Nao974/M-BOXE/M-BOXE.jpg

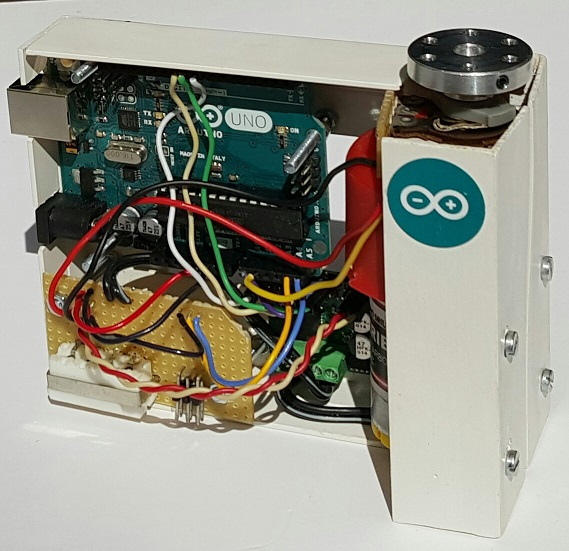
M-BOXE.jpg
