Nao974/M-BOXE/doc/Wiring.png

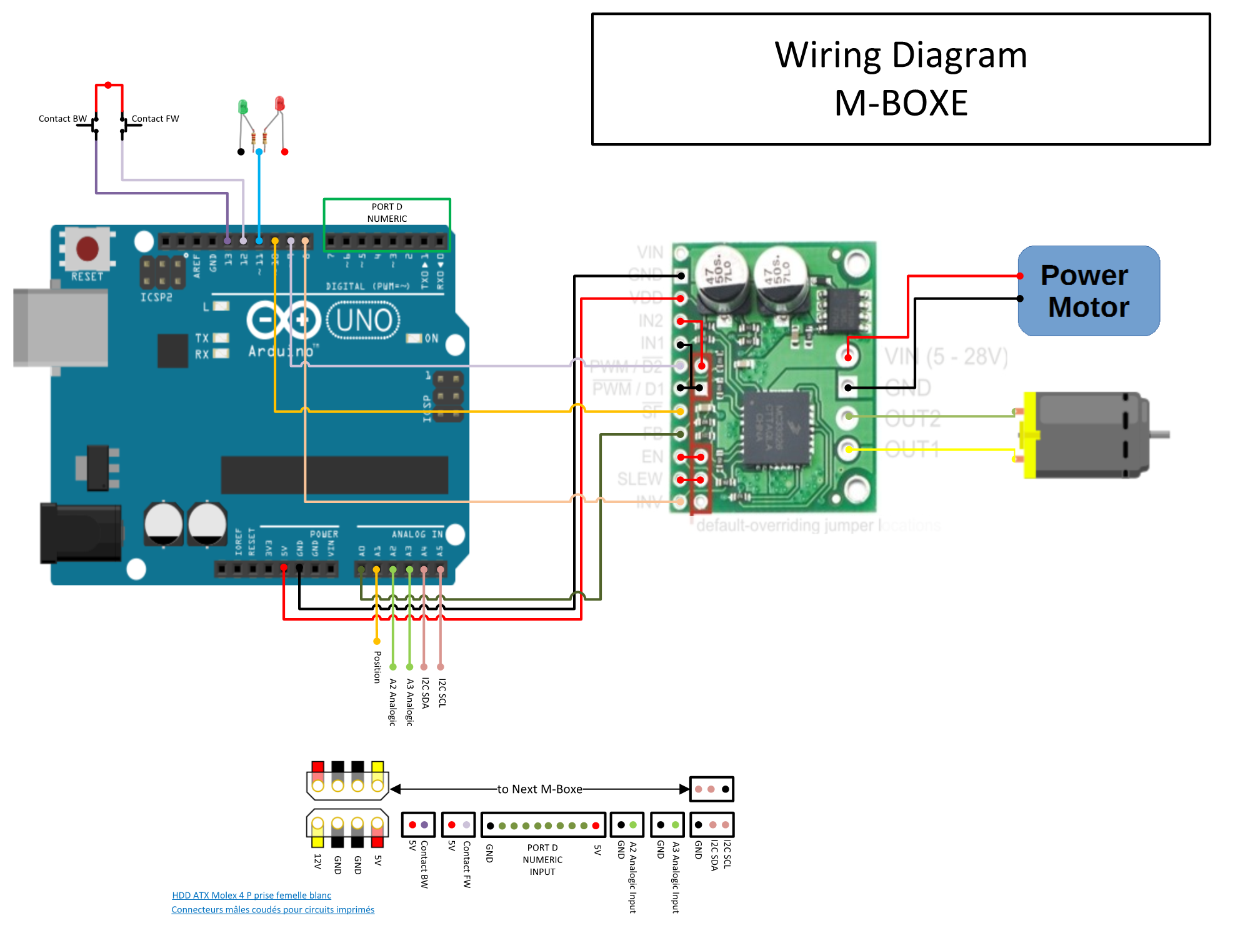
doc/Wiring.png
