Nao974/M-BOXE/history.md

# History
in [french](https://github.com/Nao974/M-BOXE/blob/master/history.md#historique)

#### Ver 0.3: ***Published on 01/03/2017***

* #c5f015 I2C reading of analog values PINA2 & PINA3
* #c5f015 I2C reading of numeric values PIN0 -> PIN7 (PortD)
* #f03c15 ~~I2C reading of the temperature~~ Switch to version 0.4
* #c5f015 Added protection status reading to code 0x44
* #c5f015 Added FW and BW contact status reading to code 0x48

#### Ver 0.4: ***Coming soon***

* Integration of protection functions
	* According to defined limits
	* Next ascending of the MC card
	* Temperature
* Status LEDs on PIN11

#### Ver 0.5: ***Later on as needed***

* Added Speed PID
	* Integration of PID Kx data
	* Integration of the min // max terminals
	* Rise following type of anomaly

#### Ver 1.0: ***Later on as needed***

* Added `PWM` command as normal servo.

---

# Historique

#### Ver 0.3: ***Publiée le 01/03/2017***

* #c5f015 Lecture par I2C des valeurs analogiques PINA2 & PINA3
* #c5f015 Lecture par I2C des valeurs numériques PIN0 -> PIN7 (PortD)
* #f03c15 ~~Lecture par I2C de la température~~ Basculé sur version 0.4
* #c5f015 Ajout de la lecture de l'état de la protection sur code 0x44
* #c5f015 Ajout de la lecture de l'état des contacts FW et BW sur code 0x48

#### Ver 0.4: ***Prochainement***

* Intégration des fonctions de protection
	* Suivant bornes définies
	* Suivant remontée de la carte MC
	* Température
* LEDs état sur PIN11

#### Ver 0.5: ***Plus en fonctions des besoins***

- Ajout du PID Vitesse
	- Intégration des données PID Kx
	- Intégration des bornes min // max
	- Remontée suivant type d'anomalie

#### Ver 1.0: ***Plus en fonctions des besoins***

* Ajout de la commande par `PWM` comme un servo normal.
