Nao974/M-BOXE/(threads)

Thread 4 (2019-04-22):

DC motor

MennaTamer, 2019-04-22:
This project is really impressive, I'm currently trying to follow your steps but with some adjustments as I am working with DC motor.
Can you please help me?

Nao974, 2019-04-25:
Hello,
thank you for your interest in my project.
Please excuse me for my English, I use an automatic translator.

I can help you with pleasure, but I have put aside for the moment this project.

There are 2 things to improve:
- the rotor of the potentiometer on the axis of the motor moves with the time. The postion becomes less precise.
=> the rotor should be turned over and the potentiometer plate placed underneath. I can make a diagram if you want.

- the second point is software. If you place an MBOXE at the joint of a shoulder, when you lower your arm, the weight quickly drops the arm and blocks a cost arrived at the position.
=> I coded a PID for the position constraint but it would also need a second PID to constrain it in speed.

Do not hesitate to ask me questions
See you soon,

Nao

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

MennaTamer, 2019-04-25:
Hi,
Thank you for your quick reply.
My main problem is that I am working on a DC motor because I’m trying to control speed and direction of an electric car, it’s almost the same concept concerning the PID and potentiometer however I believe there will be changes in the codes and honestly I cannot adjust them because I cannot fully understand the codes.

So if you have enough free time and you can tell me how to change the codes to fit a DC motor I will be so glad.

Thank you.
Menna

On Apr 25, 2019, at 7:42 AM, BOLDODUCK François <notifications@github.com<mailto:notifications@github.com>> wrote:

Hello,
thank you for your interest in my project.
Please excuse me for my English, I use an automatic translator.

I can help you with pleasure, but I have put aside for the moment this project.

There are 2 things to improve:
- the rotor of the potentiometer on the axis of the motor moves with the time. The postion becomes less precise.
=> the rotor should be turned over and the potentiometer plate placed underneath. I can make a diagram if you want.

- the second point is software. If you place an MBOXE at the joint of a shoulder, when you lower your arm, the weight quickly drops the arm and blocks a cost arrived at the position.
=> I coded a PID for the position constraint but it would also need a second PID to constrain it in speed.

Do not hesitate to ask me questions
See you soon,

Nao

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

Nao974, 2019-05-06:
Hello,
My mounting allows to control a DC motor but for a given angle, it can not do a full revolution because of the potentiometer.
It works as a servo motor.

This is not the right solution for your need. You should see a motor with an encoder to calculate its speed and deduce the speed of the car according to the gears and the size of the wheels.

goodbye

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
